GabrielVantuil/Lights-control/CAD/upper lights limiter.SLDPRT

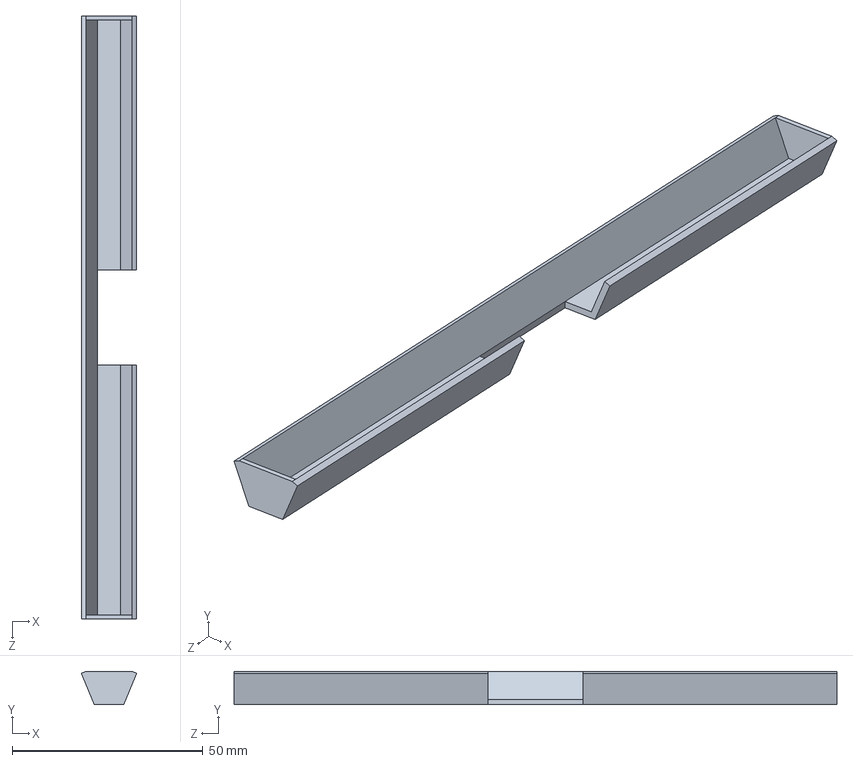
[picture p1: CAD file, 2025-01-17]
CAD/upper lights limiter.SLDPRT
14.5 x 8.69 x 158.0 mm
