GabrielVantuil/Lights-control/Eletronics/IR controlled lights/untitled.brd

## EAGLE design Eletronics/IR controlled lights/untitled.brd (2025-01-17)

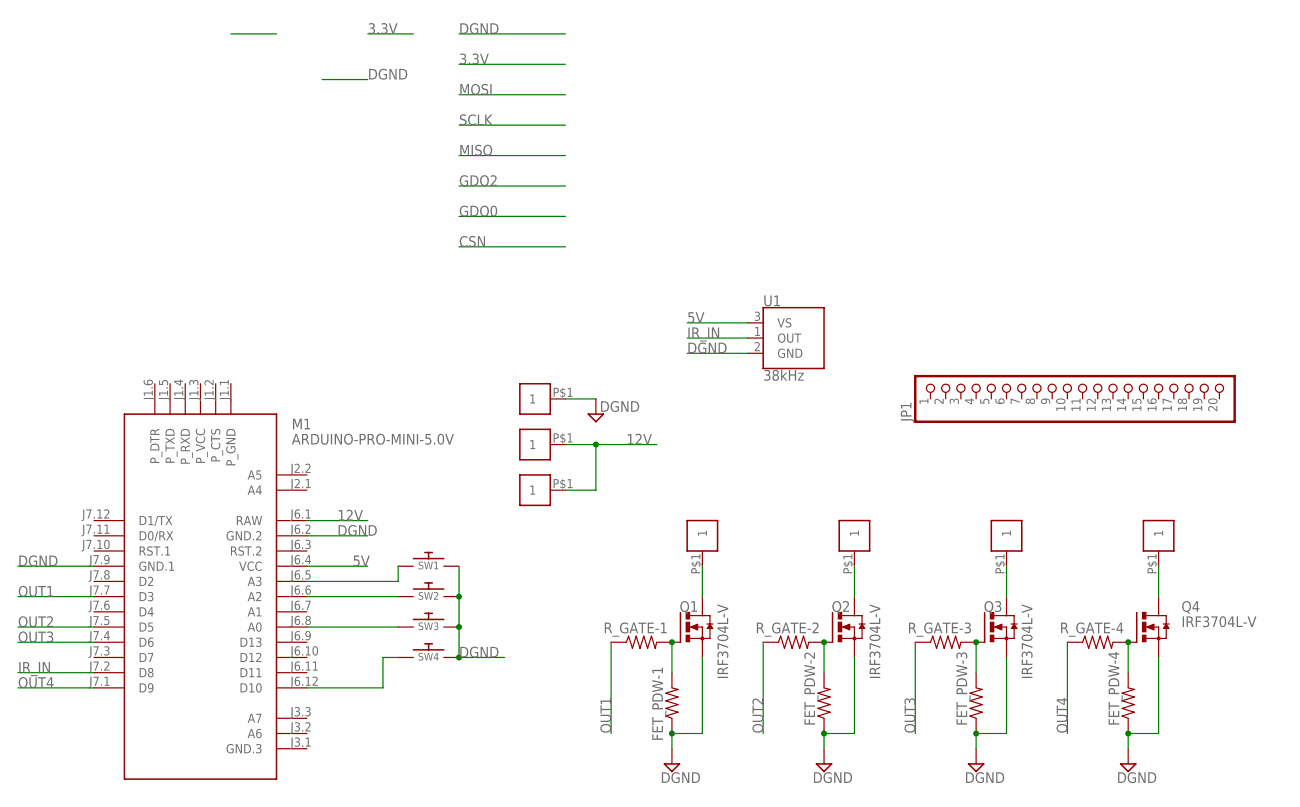
[picture p2: schematic untitled.sch]

Parts:
FET_PDW-1, FET_PDW-2, FET_PDW-3, FET_PDW-4: RESISTOR0603-RES; 0603-RES
JP1: PINHD-1X20; 1X20
M1: ARDUINO-PRO-MINI-5.0V; ARDUINO-PRO-MINI
Q1, Q2, Q3, Q4: IRF3704L-V; TO262-V
R_GATE-1, R_GATE-2, R_GATE-3, R_GATE-4: RESISTOR0603-RES; 0603-RES
SW1, SW2, SW3, SW4: SWITCH_PUSHBUTTONC&K_KSS; BTN_CK_KSS
U1: 38kHz; TSOP382
U$2, U$3, U$4, U$5, U$6, U$7, U$8: 1X01_2.54MM

Connections:
5V: M1.J6.4 (VCC), U1.3 (VS)
12V: M1.J6.1 (RAW), U$5.P$1, U$8.P$1
DGND: FET_PDW-1.1, FET_PDW-2.1, FET_PDW-3.1, FET_PDW-4.1, M1.J6.2 (GND.2), M1.J7.9 (GND.1), Q1.3 (S), Q2.3 (S), Q3.3 (S), Q4.3 (S), SW1.P$2, SW2.P$2, SW3.P$2, SW4.P$2, U1.2 (GND), U$7.P$1
IR_IN: M1.J7.2 (D8), U1.1 (OUT)
unnamed: FET_PDW-1.2, Q1.1 (G), R_GATE-1.2
unnamed: FET_PDW-2.2, Q2.1 (G), R_GATE-2.2
unnamed: FET_PDW-3.2, Q3.1 (G), R_GATE-3.2
unnamed: Q1.2 (D), U$2.P$1
unnamed: Q2.2 (D), U$3.P$1
unnamed: Q3.2 (D), U$4.P$1
unnamed: FET_PDW-4.2, Q4.1 (G), R_GATE-4.2
unnamed: Q4.2 (D), U$6.P$1
unnamed: M1.J6.5 (A3), SW1.P$1
unnamed: M1.J6.6 (A2), SW2.P$1
unnamed: M1.J6.8 (A0), SW3.P$1
unnamed: M1.J6.12 (D10), SW4.P$1
OUT1: M1.J7.7 (D3), R_GATE-1.1
OUT2: M1.J7.5 (D5), R_GATE-2.1
OUT3: M1.J7.4 (D6), R_GATE-3.1
OUT4: M1.J7.1 (D9), R_GATE-4.1

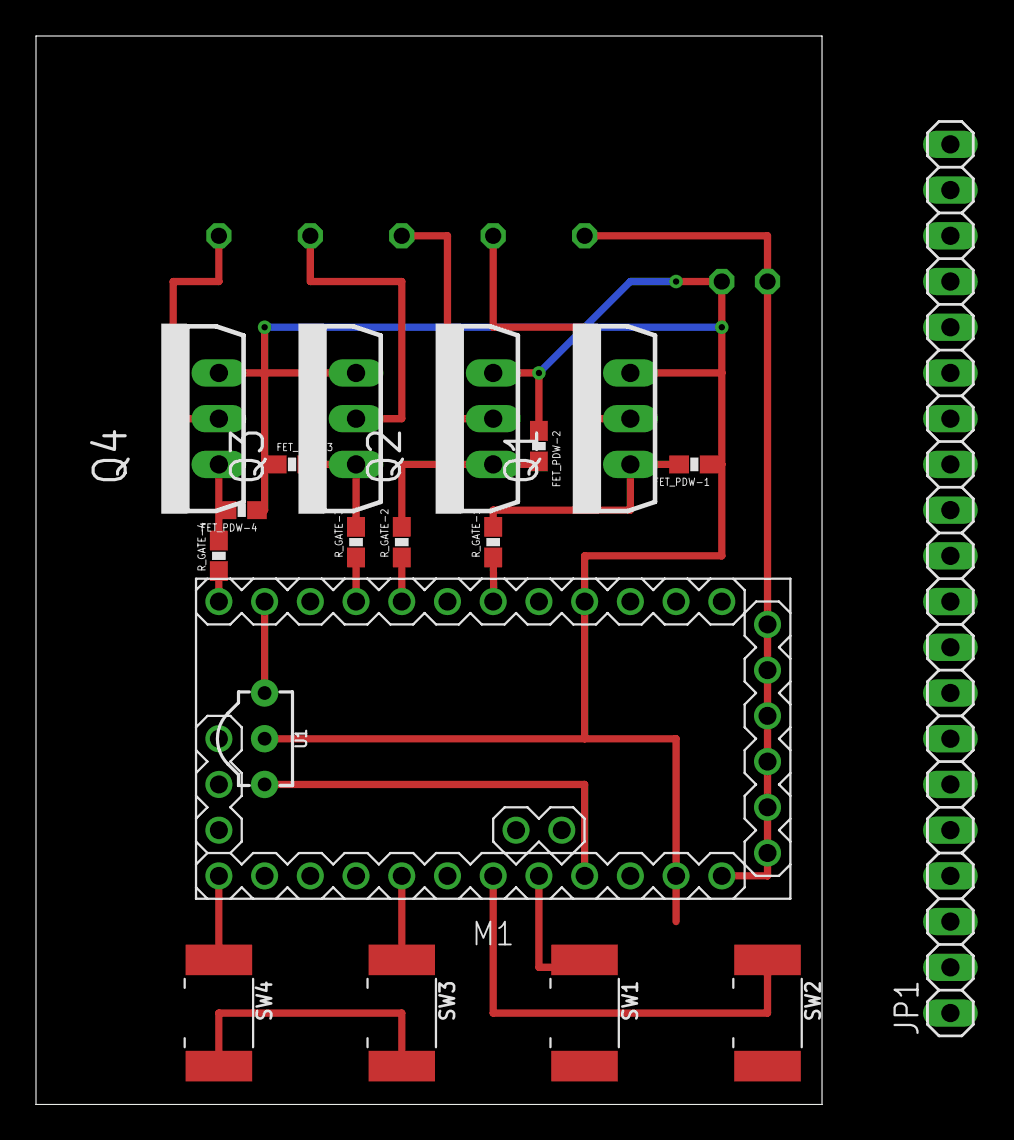
[picture p3: board untitled.brd from above]

Board: 2 copper layers, 43.7 x 59.4 mm, 26 parts (0 on the bottom side), 20 nets.
