GabrielVantuil/Lights-control/Eletronics/Lights-ctrl/Lights-ctrl rev02/Lights-ctrl rev02.brd

## EAGLE design Eletronics/Lights-ctrl/Lights-ctrl rev02/Lights-ctrl rev02.brd (2025-01-17, an earlier design)

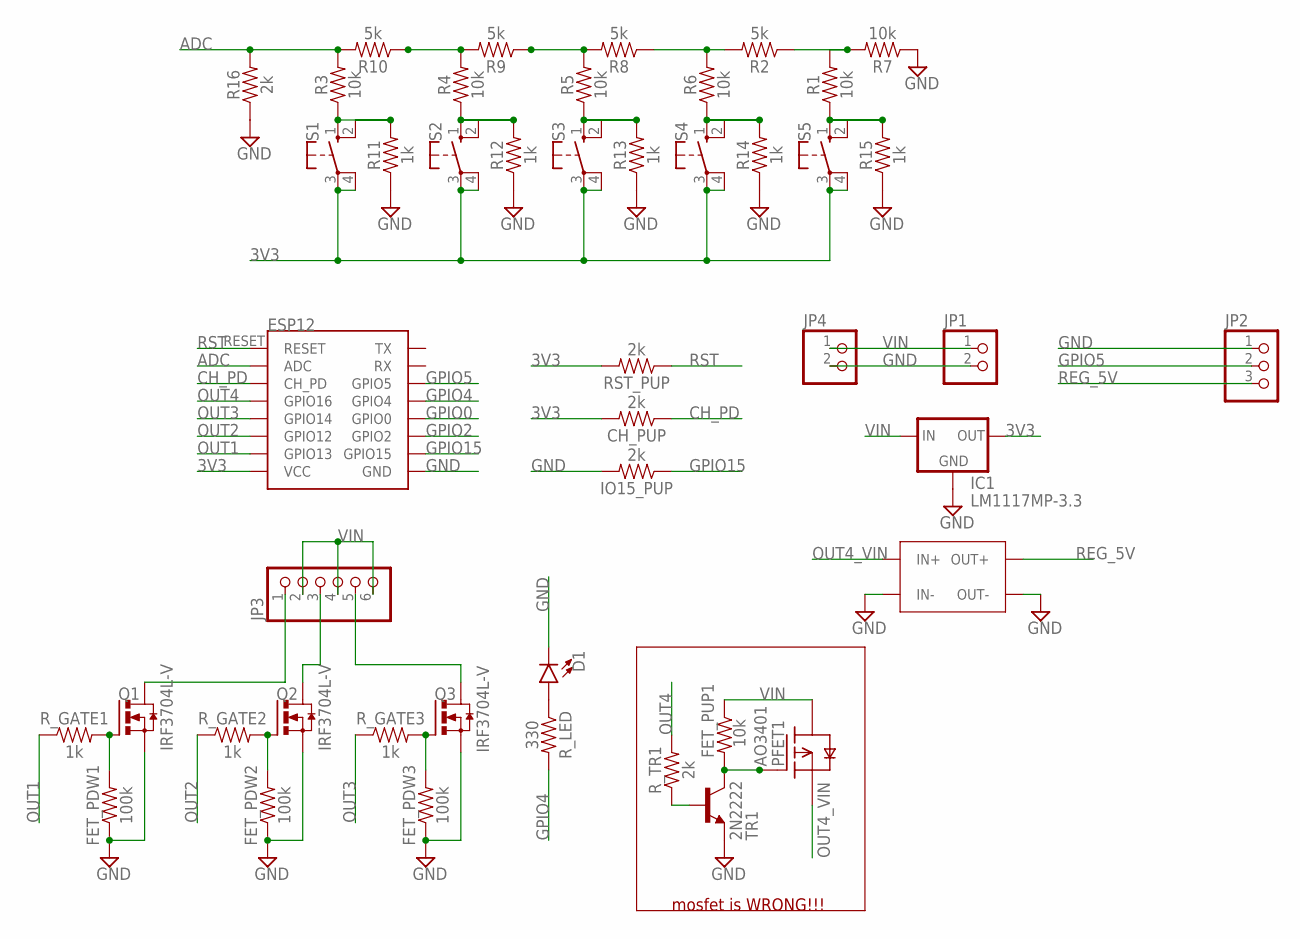
[picture p4: schematic Lights-ctrl rev02.sch]

Parts:
CH_PUP: 2k; 0603
D1: LED5MM-KIT; LED_5MM-KIT
FET_PDW1, FET_PDW2, FET_PDW3: 100k; 0603
FET_PUP1: 10k; 0603
IC1: LM1117MP-3.3; SOT223
IO15_PUP: 2k; 0603
JP1, JP4: PINHD-1X2; 1X02
JP2: PINHD-1X3; 1X03
JP3: PINHD-1X6/90; 1X06/90
PFET1: AO3401; SOT23-3
Q1, Q2, Q3: IRF3704L-V; TO262-V
R1, R3, R4, R5, R6, R7: 10k; 0603
R2, R8, R9, R10: 5k; 0603
R11, R12, R13, R14, R15: 1k; 0603
R16: 2k; 0603
RST_PUP: 2k; 0603
R_GATE1, R_GATE2, R_GATE3: 1k; 0603
R_LED: 330; 0603
R_TR1: 2k; 0603
S1, S2, S3, S4, S5: 10-XX; B3F-10XX
TR1: 2N2222; SOT23-BEC
U$1: ESP12E-CASTELLATED
U$4: XL4005

Connections:
3V3: CH_PUP.2, IC1.2 (OUT), IC1.4 (OUT), RST_PUP.2, S1.3, S1.4 (P1), S2.3, S2.4 (P1), S3.3, S3.4 (P1), S4.3, S4.4 (P1), S5.3, S5.4 (P1), U$1.VCC
ADC: R3.2, R10.2, R16.2, U$1.ADC
CH_PD: CH_PUP.1, U$1.CH_PD
GND: D1.K (C), FET_PDW1.1, FET_PDW2.1, FET_PDW3.1, IC1.1 (GND), IO15_PUP.2, JP1.2, JP2.1, JP4.2, Q1.3 (S), Q2.3 (S), Q3.3 (S), R7.1, R11.1, R12.1, R13.1, R14.1, R15.1, R16.1, TR1.E, U$1.GND, U$4.IN-, U$4.OUT-
GPIO0: U$1.GPIO0
GPIO2: U$1.GPIO2
GPIO4: R_LED.2, U$1.GPIO4
GPIO5: JP2.2, U$1.GPIO5
GPIO15: IO15_PUP.1, U$1.GPIO15
unnamed: JP3.1, Q1.2 (D)
unnamed: R2.2, R6.2, R8.1
unnamed: R5.2, R8.2, R9.1
unnamed: R4.2, R9.2, R10.1
unnamed: D1.A, R_LED.1
unnamed: R3.1, R11.2, S1.1 (S), S1.2 (S1)
unnamed: R_TR1.1, TR1.B
unnamed: FET_PUP1.2, PFET1.1 (G), TR1.C
unnamed: R1.1, R15.2, S5.1 (S), S5.2 (S1)
unnamed: JP3.3, Q2.2 (D)
unnamed: JP3.5, Q3.2 (D)
unnamed: FET_PDW1.2, Q1.1 (G), R_GATE1.2
unnamed: R1.2, R2.1, R7.2
unnamed: R4.1, R12.2, S2.1 (S), S2.2 (S1)
unnamed: FET_PDW2.2, Q2.1 (G), R_GATE2.2
unnamed: FET_PDW3.2, Q3.1 (G), R_GATE3.2
unnamed: R5.1, R13.2, S3.1 (S), S3.2 (S1)
unnamed: R6.1, R14.2, S4.1 (S), S4.2 (S1)
OUT1: R_GATE1.1, U$1.GPIO13
OUT2: R_GATE2.1, U$1.GPIO12
OUT3: R_GATE3.1, U$1.GPIO14
OUT4: R_TR1.2, U$1.GPIO16
OUT4_VIN: PFET1.2 (S), U$4.IN+
REG_5V: JP2.3, U$4.OUT+
RST: RST_PUP.1, U$1.RESET
VIN: FET_PUP1.1, IC1.3 (IN), JP1.1, JP3.2, JP3.4, JP3.6, JP4.1, PFET1.3 (D)

Notes on the sheet:
mosfet is WRONG!!!

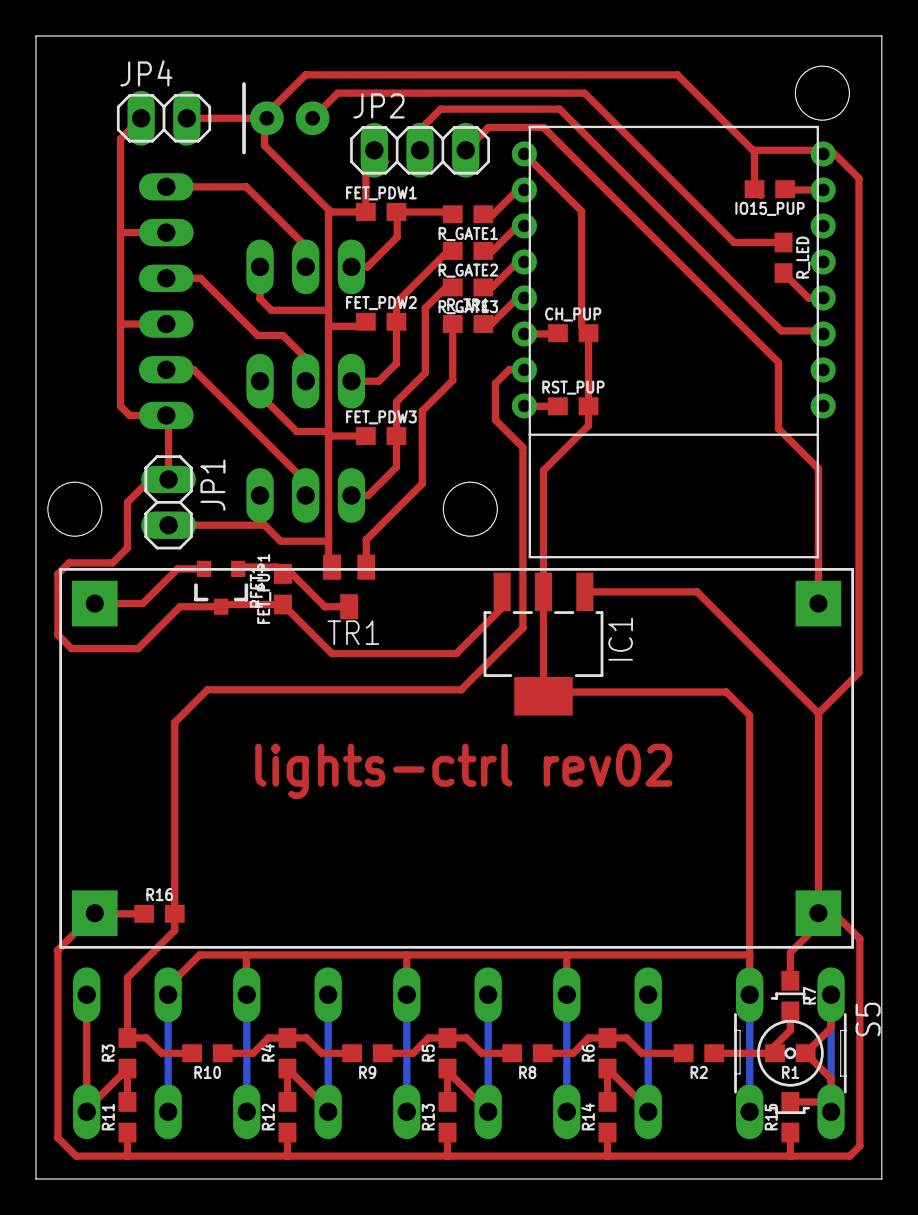
[picture p5: board Lights-ctrl rev02.brd from above]

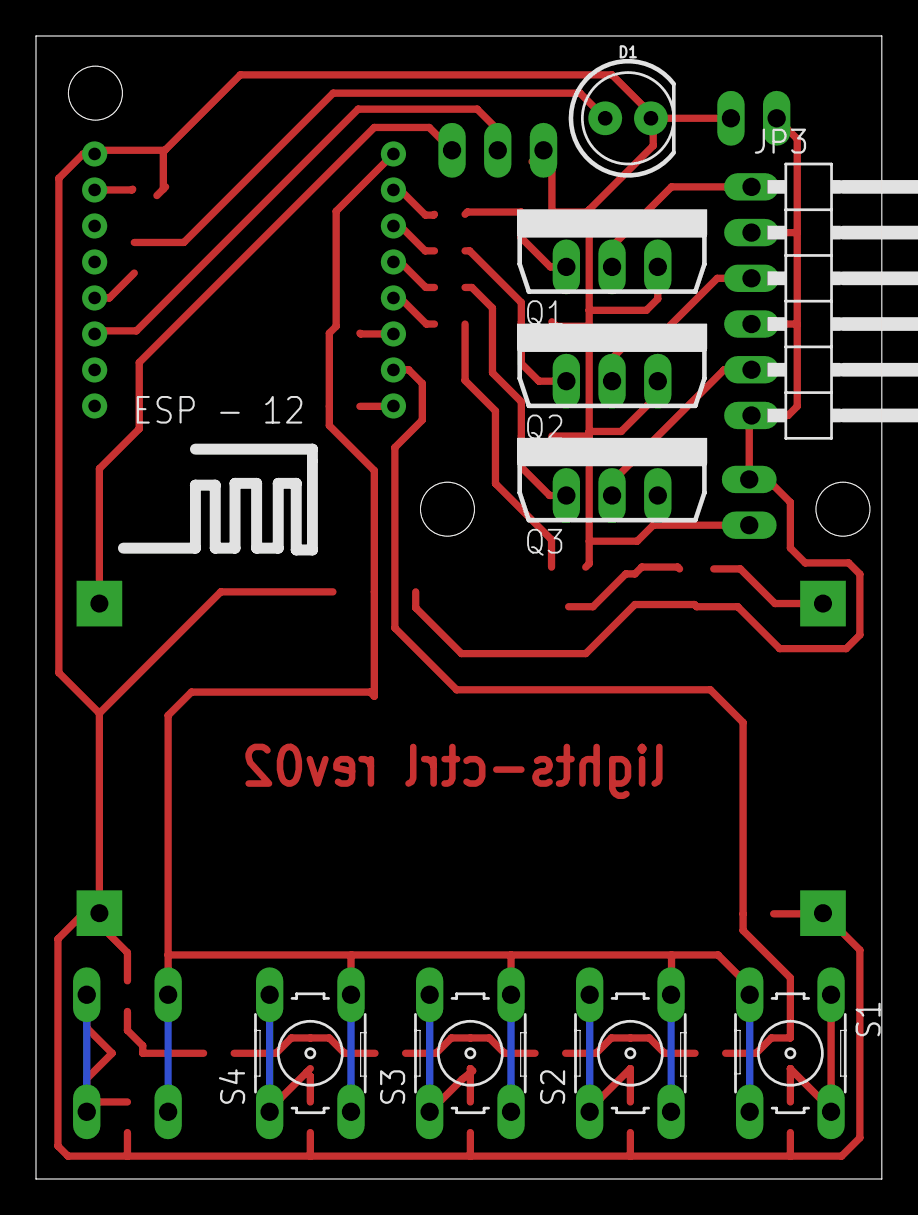
[picture p6: board Lights-ctrl rev02.brd from below]

Board: 2 copper layers, 47.0 x 63.5 mm, 46 parts (10 on the bottom side), 33 nets.
