GabrielVantuil/Lights-control/Eletronics/Lights-ctrl/Lights-ctrl rev03/Lights-ctrl rev03.brd

## EAGLE design Eletronics/Lights-ctrl/Lights-ctrl rev03/Lights-ctrl rev03.brd (2025-01-17)

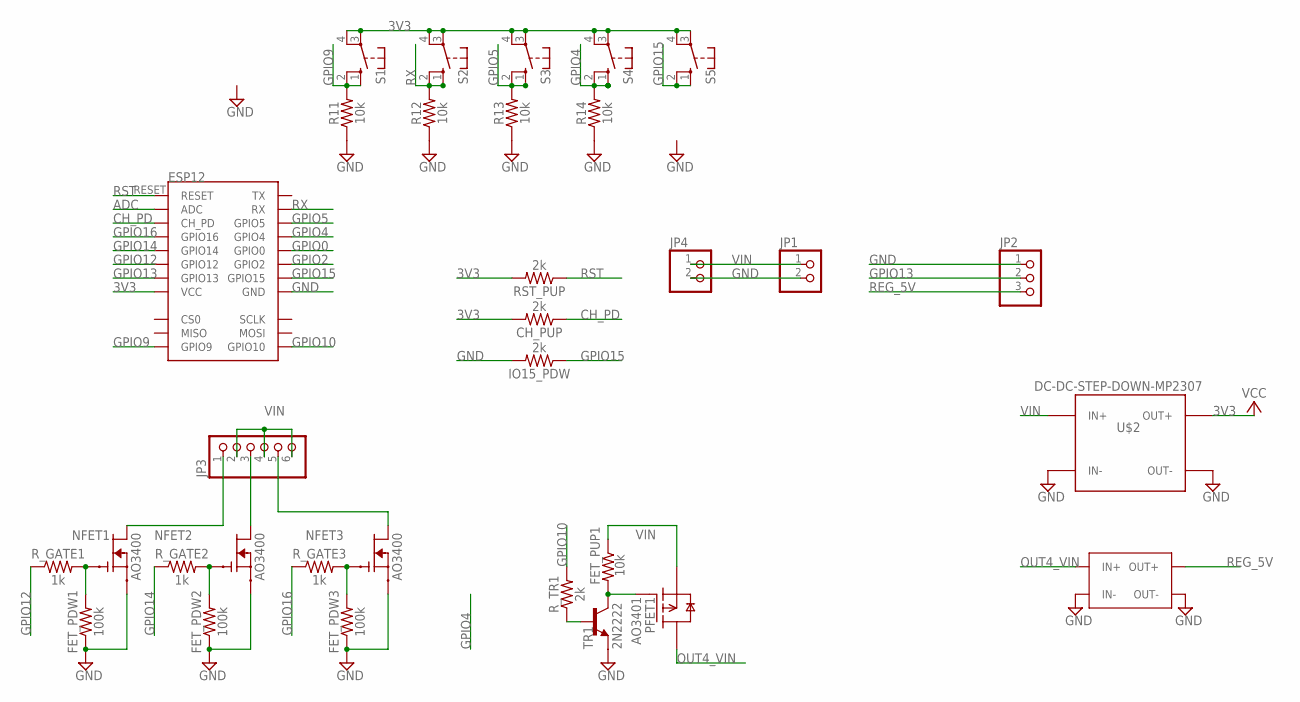
[picture p7: schematic Lights-ctrl rev03.sch]

Parts:
CH_PUP: 2k; 0603
FET_PDW1, FET_PDW2, FET_PDW3: 100k; 0603
FET_PUP1: 10k; 0603
IO15_PDW: 2k; 0603
JP1, JP4: PINHD-1X2; 1X02
JP2: PINHD-1X3; 1X03
JP3: PINHD-1X6/90; 1X06/90
NFET1, NFET2, NFET3: AO3400; SOT23-3
PFET1: AO3401; SOT23-3
R11, R12, R13, R14: 10k; 0603
RST_PUP: 2k; 0603
R_GATE1, R_GATE2, R_GATE3: 1k; 0603
R_TR1: 2k; 0603
S1, S2, S3, S4, S5: 10-XX; B3F-10XX
TR1: 2N2222; SOT23-BEC
U$1: ESP12E-CASTELLATED
U$2: DC-DC-STEP-DOWN-MP2307
U$4: XL4005

Connections:
3V3: CH_PUP.2, RST_PUP.2, S1.3, S1.4 (P1), S2.3, S2.4 (P1), S3.3, S3.4 (P1), S4.3, S4.4 (P1), S5.3, S5.4 (P1), U$1.VCC, U$2.OUT+
ADC: U$1.ADC
CH_PD: CH_PUP.1, U$1.CH_PD
GND: FET_PDW1.1, FET_PDW2.1, FET_PDW3.1, IO15_PDW.2, JP1.2, JP2.1, JP4.2, NFET1.2 (S), NFET2.2 (S), NFET3.2 (S), R11.1, R12.1, R13.1, R14.1, TR1.E, U$1.GND, U$2.IN-, U$2.OUT-, U$4.IN-, U$4.OUT-
GPIO0: U$1.GPIO0
GPIO2: U$1.GPIO2
GPIO4: R14.2, S4.1 (S), S4.2 (S1), U$1.GPIO4
GPIO5: R13.2, S3.1 (S), S3.2 (S1), U$1.GPIO5
GPIO9: R11.2, S1.1 (S), S1.2 (S1), U$1.GPIO9
GPIO10: R_TR1.2, U$1.GPIO10
GPIO12: R_GATE1.1, U$1.GPIO12
GPIO13: JP2.2, U$1.GPIO13
GPIO14: R_GATE2.1, U$1.GPIO14
GPIO15: IO15_PDW.1, S5.1 (S), S5.2 (S1), U$1.GPIO15
GPIO16: R_GATE3.1, U$1.GPIO16
unnamed: JP3.1, NFET1.3 (D)
unnamed: R_TR1.1, TR1.B
unnamed: FET_PUP1.2, PFET1.1 (G), TR1.C
unnamed: JP3.3, NFET2.3 (D)
unnamed: JP3.5, NFET3.3 (D)
unnamed: FET_PDW1.2, NFET1.1 (G), R_GATE1.2
unnamed: FET_PDW2.2, NFET2.1 (G), R_GATE2.2
unnamed: FET_PDW3.2, NFET3.1 (G), R_GATE3.2
OUT4_VIN: PFET1.3 (D), U$4.IN+
REG_5V: JP2.3, U$4.OUT+
RST: RST_PUP.1, U$1.RESET
RX: R12.2, S2.1 (S), S2.2 (S1), U$1.RX
VIN: FET_PUP1.1, JP1.1, JP3.2, JP3.4, JP3.6, JP4.1, PFET1.2 (S), U$2.IN+

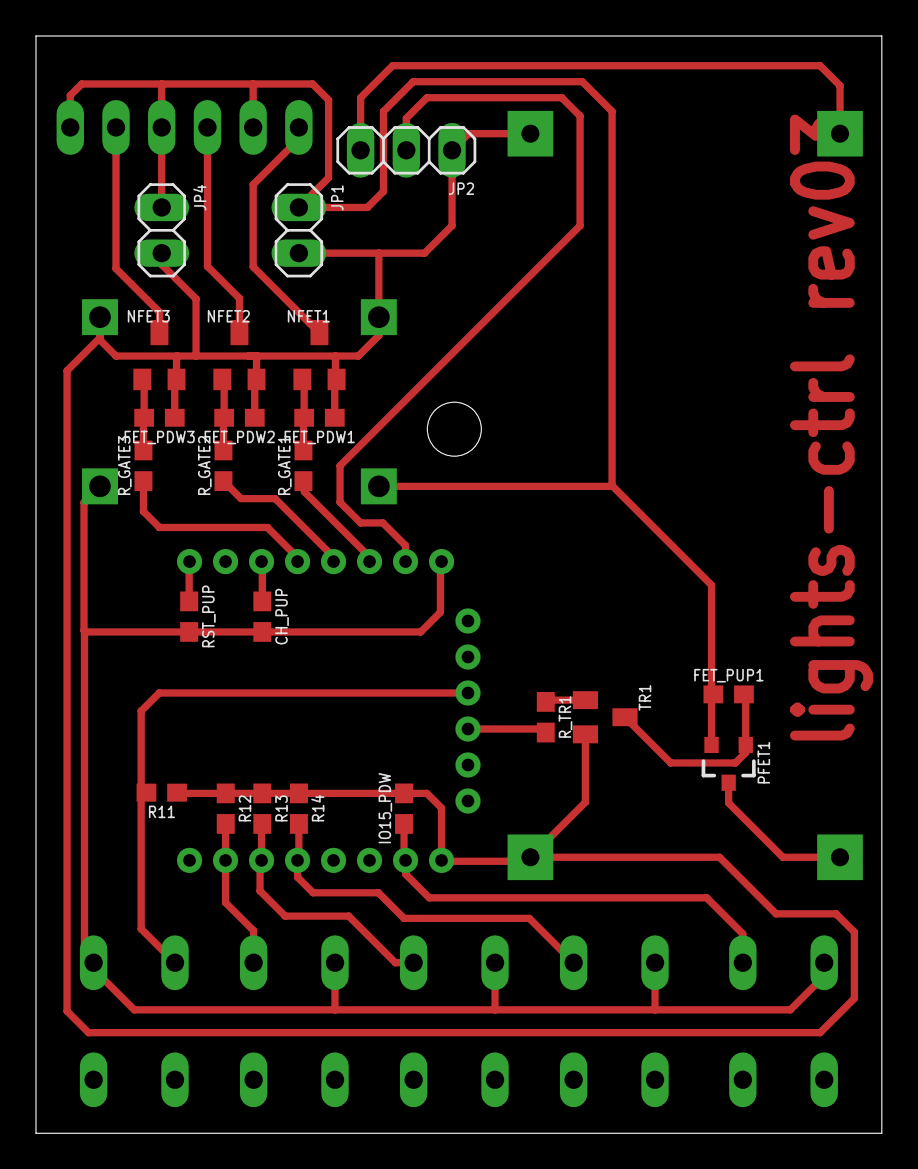
[picture p8: board Lights-ctrl rev03.brd from above]

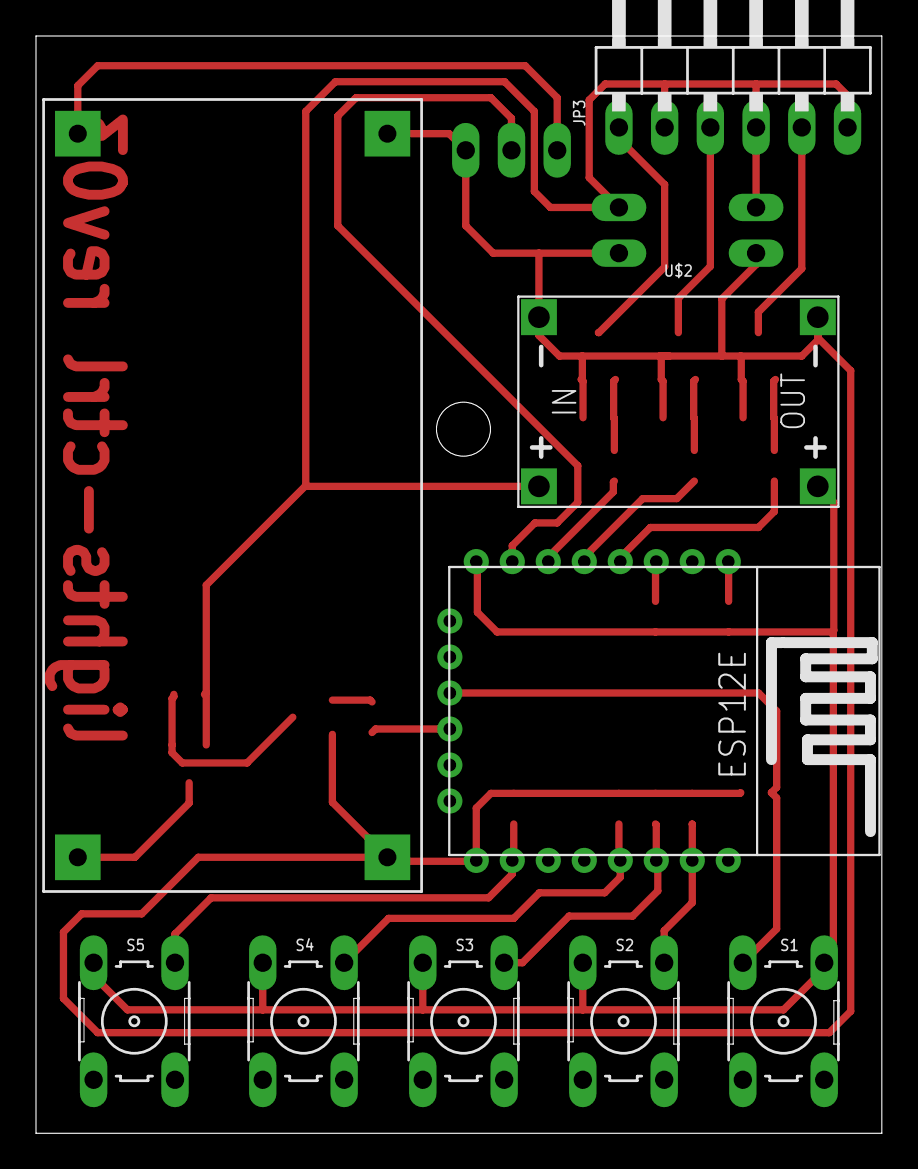
[picture p9: board Lights-ctrl rev03.brd from below]

Board: 2 copper layers, 47.0 x 61.0 mm, 32 parts (9 on the bottom side), 25 nets.
