GabrielVantuil/Lights-control/src/lights_ctrl_rev03/alexaConfig.h

#ifndef ALEXA_CONFIG_H__
#define ALEXA_CONFIG_H__

#include <arduino.h>
#include <Espalexa.h>
#include "neopixelFunctions.h"
#include "board_config.h"

extern Espalexa espalexa;

void addDevices();

#endif
