GabrielVantuil/Lights-control/src/lights_ctrl_rev03/board_config.h

#ifndef BOARD_CONFIG_H__
#define BOARD_CONFIG_H__

#define OUT0 12
#define OUT1 14
#define OUT2 16
#define OUT3 10 //neopixel's mosfet
#define BUTTON0 15
#define BUTTON1 4
#define BUTTON2 5
#define BUTTON3 3 //RX
#define BUTTON4 9
#define ALT_BUTTON BUTTON4
#define AUXILIAR_LED 13
const uint8_t BUTTON[] = {BUTTON0,BUTTON1,BUTTON2,BUTTON3,BUTTON4};
const uint8_t OUT[] = {OUT0,OUT1,OUT2,OUT3};

#define NEOPIXEL_PIN 0

#define NUMPIXELS 91

#endif
