GabrielVantuil/Lights-control/src/ir_controlled_lights/readme.ino

/*
 * All commands were made based on Samsung's IR remote
 *  
 * To start any command, press the cube symbol
 * - The coloured circles indicate which channel will be lit
 * - To control intensity, press up and down after choosing the channel
 * - To increase/decrease all intensity, do not select any channel
 * 
 * 
 * After starting a command, you have 5 seconds to finish, reseting after each button press
 * 
 * 
 * Because of the IR library, pwm on pin 3 wont work
 */
